fsi270308/-/README.md

### 高原气压模拟装置 ###
* __用于模拟高原大气压力，在模拟环境下测试产品的可靠性。__
---
> 电路原理
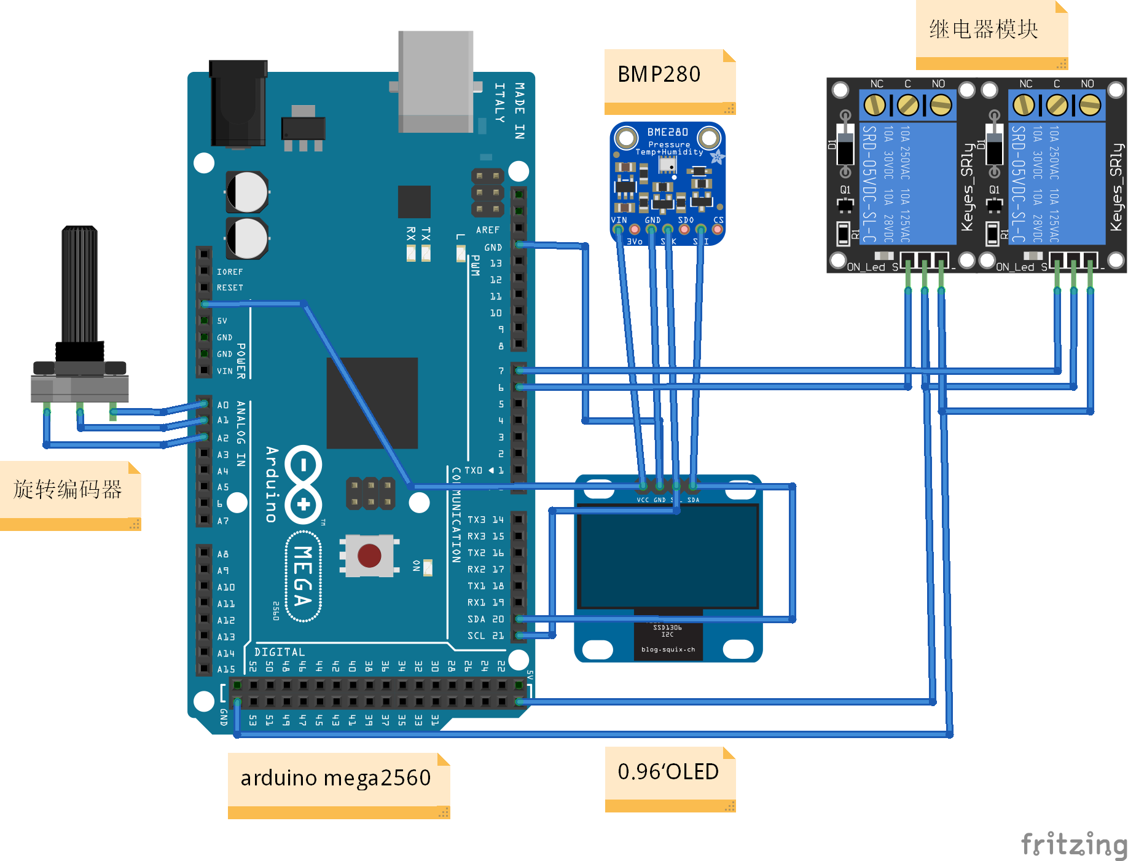
[picture p1: APSD_bb.png]
电路原理
> 
> 
> [详细内容见JZ-APSD.ino](/JZ-APSD.ino)
> 
> [操作说明](https://shimo.im/docs/Y8nY2oTyeAoOTrNK/)
