fsi270308/-/JZ-APSD.ino

/*
 * 2017/06/12  MaFeng
 * 大气压力模拟装置
 *    主控板：  Mega2560
 *    
 *    气压检测：BMP280模块
 *      接线方式：I2C  VCC->3.3V   GND->GND   SCL->SCL   SDA->SDA
 *      通信地址：0x76（在库Adafruit_BME280.h中修改）
 *      
 *    显示屏：12864 OLED模块0.96寸 （SSD1306_128X64）
 *      接线方式：I2C  VCC->3.3V   GND->GND   SCL->SCL   SDA->SDA
 *      通信地址：0x3C (Adafruit_SSD1306库，使用find_ad程序查找)
 *      
 *    操控按钮：旋转编码器模块 (RotaryEncoder)
 *      接线方式：CLK->A1  DT->A0  SW->A2  +->5V   GND->GND
 *      库：https://github.com/0xPIT/encoder/tree/arduino
 *      TimerOne库：https://github.com/PaulStoffregen/TimerOne
 *      旋转编码器原理：http://howtomechatronics.com/tutorials/arduino/rotary-encoder-works-use-arduino/
 *      参考：
 *      库：https://github.com/mathertel/RotaryEncoder     
 *      
 *    直流电机驱动： 继电器模块 光耦隔离低触发 12V
 *      接线方式：IN1->D6  IN2->D7
 *    
 *    当前大气压查询网址：中央气象台
 *    http://www.nmc.cn/publish/forecast/AJX/nanchang.html
 *    海平面气压的计算公式是：
 *        P0=Ps×10^[h/18400(1+Tm/273)]
 *    式中
 *        P0为海平面气压，单位hPa；
 *        Ps为本站气压，单位hPa；
 *        h为气压传感器拔海高度，单位为m；
 *        Tm为气柱平均温度，单位为℃，Tm=（t+t12)/2+h/400；
 *        t为干球温度，单位℃；
 *        t12为观测前12小时气温，单位℃。
 *        
 *    本地当天海平面气压查询网址：
 *    http://www.t7online.com//cgi-bin/regframe?3&PRG=detail&TIME=std&LANG=cn&WMO=58606&ART=luftdruck
 *    2017/6/13 14：00 南昌 海平面气压为：1007hpa  办公室海拔20m
 *    
 *    标准海平面气压为：1013.25hpa
 *    
 * 2017.6.18
 * 菜单程序测试成功
 * 2017.6.20
 * 增加继电器控制程序
 * 2017.6.23
 * 试验，泵启动到达设定值，补偿几次之后死机，泵工作不停。
 * 旋转编码器使用了中断，与I2C通讯冲突。
 * 2017.6.24
 * 死机原因参考1：http://www.dfrobot.com.cn/community/thread-12607-1-1.html
 * 死机原因参考2：http://www.wendangku.net/doc/8793f268561252d380eb6e79.html
 *    1.已在主循环中读取开关变量前关闭全局中断，完成后打开全局中断。
 *    2.减少函数调用层级，减少局部变量，测试30分钟，未死机。
 *    3.运行中气压传感器线接头接触不良也有可能导致死机。
 *    4.电源需接地，信号线加滤波器
 *    5.高速信号线I2C远离信号输入端
 * 2017.6.26
 * 程序优化，追加buff2，进一步减少局部变量。
 * 加看门狗Adafruit_SleepyDog.h，加断电保存，
 * EEPROM保存float型数据参考：http://www.arduino.cn/thread-2684-1-1.html
 * 2017.6.27
 * 原来是OLED连接线问题，排线时候使用了一根U槽传感器的四芯线，较细，而且有1米左右，线路绕在开关电源附近；
 * 更换了一根较粗的半米长四芯线，远离开关电源，问题解除，看门狗也不需要了。：P
 * 2017.6.29
 * 重做断电保存，更换库<EEPROM.h>为<EEPROMex.h>，更方便的存取各类数值。
*/

//----------------------加载库文件--------------------------------------------
#include <SPI.h>
#include <Wire.h>
#include <Adafruit_GFX.h>
#include <Adafruit_SSD1306.h>

#include <Adafruit_Sensor.h>  //气压传感器库
#include <Adafruit_BME280.h>  //气压传感器库

#include <ClickEncoder.h>
#include <TimerOne.h>

#include <EEPROMex.h>

#include <Adafruit_SleepyDog.h>

//----------------------大气压传感器本地海平面设置--------------------------------------
#define SEALEVELPRESSURE_HPA (seaLevelPressure)  //当地当天海平面大气压

//----------------------大气压传感器接线方式定义-------------------------------------------------
Adafruit_BME280 bme; // I2C

//----------------------OLED屏设置------------------------------------
#define OLED_RESET 4
Adafruit_SSD1306 display(OLED_RESET);

#define NUMFLAKES 10
#define XPOS 0
#define YPOS 1
#define DELTAY 2

#if (SSD1306_LCDHEIGHT != 64)
#error("Height incorrect, please fix Adafruit_SSD1306.h!");
#endif

//----------------------定义变量------------------------------------
int menuitem = 1;
int frame = 1;
int page = 2;
int lastMenuItem = 1;

String menuItem1 = "Home Screen";
String menuItem2 = "Sea Level Pressure";
String menuItem3 = "Simulation Altitude";
String menuItem4 = "Buff1";
String menuItem5 = "Buff2";
String menuItem6 = "Reset";

boolean vacuumPump = false;
int seaLevelPressure = 1013;
int siAltitude = 0;
float siAltitudeHm = 1.0; 
float buff1 = 20.0;  //默认大泵缓冲高度20m
float buff2 = 1.0;  //默认小泵滞后10m
int a1 = 0;
int a2 = 0;

int addr = 0;
float a3 = 0.0;
float a4 = 0.0;


boolean up = false;
boolean down = false;
boolean middle = false;

ClickEncoder *encoder;
int16_t last, value;

int pump1 = 6;    //泵1控制线D6
int pump2 = 7;    //泵2控制线D7
int i = 0;


void setup()   
{
  encoder = new ClickEncoder(A0, A1, A2);  //CLK -> A1; DT -> A0; SW -> A2
  encoder->setAccelerationEnabled(false);

  Wire.begin();  

  display.begin(SSD1306_SWITCHCAPVCC, 0x3C); 
  display.display();
  display.clearDisplay();

  Timer1.initialize(1000);
  Timer1.attachInterrupt(timerIsr); 
  
  last = encoder->getValue();

//-----------气压传感器启动----------------------------------
  bme.begin();
//------------真空泵初始化-----------------------------------
  pinMode(pump1, OUTPUT);
  pinMode(pump2, OUTPUT);
  digitalWrite(pump1, HIGH);
  digitalWrite(pump2, HIGH);
  
//------------EEPROM------------------------------------
        a1 = EEPROM.readInt(0);
        a2 = EEPROM.readInt(2);
        a3 = EEPROM.readFloat(4);
        a4 = EEPROM.readFloat(8);

  seaLevelPressure = a1;
  siAltitude = a2;
  buff2 = a3;
  buff1 = a4;
}



//-------------------↓↓↓Loop↓↓↓----------------------------------------------------
void loop() 
{  
    if(bme.readAltitude(SEALEVELPRESSURE_HPA) < siAltitudeHm)
    {
      if(bme.readAltitude(SEALEVELPRESSURE_HPA) < siAltitudeHm - buff1)
      {
        digitalWrite(pump1, LOW);   //pump1Start
        digitalWrite(pump2, LOW);   //pump2Start
        
      }
      else if(bme.readAltitude(SEALEVELPRESSURE_HPA) >= siAltitudeHm - buff1 && bme.readAltitude(SEALEVELPRESSURE_HPA) < siAltitudeHm - buff2)
      {
        digitalWrite(pump1, HIGH);   //pump1Stop
        digitalWrite(pump2, LOW);   //pump2Start
       vacuumPump = true;       
      }
    }
    else if(bme.readAltitude(SEALEVELPRESSURE_HPA) >= siAltitudeHm + buff2)
    {
      digitalWrite(pump1, HIGH);   //pump1Stop
      digitalWrite(pump2, HIGH);   //pump2Stop
      
    }

    if(vacuumPump)
    {
      vacuumPump = false;
      i ++;
      delay(200);
    }
    if(i >= 100)
    {
      i = 0;
      Watchdog.enable(50);   //补偿n次后看门狗启动。
      
    }
  
  siAltitudeHm = siAltitude * 100;   //显示为n百米
  
//----------------bme读取温湿度-----------------------------------------------------
  bme.readTemperature();   //必须读取这些值才能计算出准确的大气压
  bme.readHumidity();    //必须读取这些值才能计算出准确的大气压

//------------------显示菜单----------------------------------------------------
  drawMenu();
  
//------------------旋转编码器按钮状态读取-----------------------------
   noInterrupts();
   //readRotaryEncoder();
  value += encoder->getValue();  
  if (value/2 > last) 
  {
    last = value/2;
    down = true;
    delay(150);
  }
  else if (value/2 < last) 
  {
    last = value/2;
    up = true;
    delay(50);
  }
   ClickEncoder::Button b = encoder->getButton();   
   if (b != ClickEncoder::Open) 
   {
      switch (b) 
      {
      case ClickEncoder::Clicked:
        middle = true;
        break;
      }
    }    
  interrupts();
    
  //----------------------主菜单参数递减----------------------------------------
  if (up && page == 1 ) 
  {     
    up = false;
    if(menuitem == 2 && frame == 2)
    {
      frame--;
    }
    if(menuitem == 3 && frame == 3)
    {
      frame--;
    }
    if(menuitem == 4 && frame == 4)
    {
      frame--;
    }

    
    lastMenuItem = menuitem;
    menuitem--;
    
    if (menuitem==0)
    {
      menuitem=1;
    } 
  }
  
  //----------------------子菜单参数递减-----------------------------------------
  else if (up && page == 2 && menuitem == 2 ) 
  {
    up = false;
    seaLevelPressure--;
  }
  else if (up && page == 2 && menuitem == 3 ) 
  {
    up = false;
    siAltitude--;
    if(siAltitude == -2)
    {
      siAltitude = 40;
    }
  }
  else if (up && page == 2 && menuitem == 4 ) 
  {
    up = false;
    buff1--;
    if(buff1 == -1.00)
    {
      buff1 = 100;
    }
  }
  else if (up && page == 2 && menuitem == 5 ) 
  {
    up = false;
    buff2--;
    if(buff2 == -1.00)
    {
      buff2 = 10;
    }
  }
  
//---------------------------主菜单参数递增---------------------------------------------------
  if (down && page == 1)              //We have turned the Rotary Encoder Clockwise
  {
    down = false;
    if(menuitem == 3 && lastMenuItem == 2)
    {
      frame ++;
    }
    else if(menuitem == 4 && lastMenuItem == 3)
    {
      frame ++;
    }
    else if(menuitem == 5 && lastMenuItem == 4 && frame!=4)
    {
      frame ++;
    }
    
    lastMenuItem = menuitem;
    menuitem++;  
    
    if (menuitem==7) 
    {
      menuitem--;
    }  
  }
  
  //---------------------子菜单参数递增----------------------------------------
  else if (down && page == 2 && menuitem == 2) 
  {
    down = false;
    seaLevelPressure++;
  }
  else if (down && page == 2 && menuitem == 3) 
  {
    down = false;
    siAltitude++;
    if(siAltitude == 41)
    {
      siAltitude = -1;
    }
  }
  else if (down && page == 2 && menuitem == 4) 
  {
    down = false;
    buff1++;
    if(buff1 == 101.00)
    {
      buff1 = 0;
    }
   }
  else if (down && page == 2 && menuitem == 5) 
  {
    down = false;
    buff2++;
    if(buff2 == 11.00)
    {
      buff2 = 0;
    }
   }
  
  //-------------------中间按钮按下---------------------------------------
  if (middle) //Middle Button is Pressed
  {
    middle = false;
    if(page == 1 && menuitem == 6)      // Reset
    {
      resetDefaults();
    }
    else if (page == 1 && menuitem <= 5) 
    {
      page=2;
     }
    else if (page == 2) 
     {
      page=1; 
      
      a1 = seaLevelPressure;
      a2 = siAltitude;
      a3 = buff2;
      a4 = buff1;
 
      EEPROM.updateInt(0, a1);
      EEPROM.updateInt(2, a2);
      EEPROM.updateFloat(4, a3);
      EEPROM.updateFloat(8, a4);
     }
   }   
  }
//--------------------------↑↑↑Loop↑↑↑------------------------------------------
  
  void drawMenu()
{    
  if (page == 1) 
  {    
    display.setTextSize(1);
    display.clearDisplay();
    display.setTextColor(WHITE);
    display.setCursor(37, 0);
    display.print("MAIN MENU");
    display.drawFastHLine(0,10,128,WHITE);

    if(menuitem == 1 && frame == 1)
    {   
      displayMenuItem(menuItem1, 15,false);
      displayMenuItem(menuItem2, 25,true);
      displayMenuItem(menuItem3, 35,true);
    }
    else if(menuitem == 2 && frame == 1)
    {
      displayMenuItem(menuItem1, 15,true);
      displayMenuItem(menuItem2, 25,false);
      displayMenuItem(menuItem3, 35,true);
    }
    else if(menuitem == 3 && frame == 1)
    {
      displayMenuItem(menuItem1, 15,true);
      displayMenuItem(menuItem2, 25,true);
      displayMenuItem(menuItem3, 35,false);
    }
     else if(menuitem == 4 && frame == 2)
    {
      displayMenuItem(menuItem2, 15,true);
      displayMenuItem(menuItem3, 25,true);
      displayMenuItem(menuItem4, 35,false);
    }

      else if(menuitem == 3 && frame == 2)
    {
      displayMenuItem(menuItem2, 15,true);
      displayMenuItem(menuItem3, 25,false);
      displayMenuItem(menuItem4, 35,true);
    }
    else if(menuitem == 2 && frame == 2)
    {
      displayMenuItem(menuItem2, 15,false);
      displayMenuItem(menuItem3, 25,true);
      displayMenuItem(menuItem4, 35,true);
    }
    
    else if(menuitem == 5 && frame == 3)
    {
      displayMenuItem(menuItem3, 15,true);
      displayMenuItem(menuItem4, 25,true);
      displayMenuItem(menuItem5, 35,false);
    }

    else if(menuitem == 6 && frame == 4)
    {
      displayMenuItem(menuItem4, 15,true);
      displayMenuItem(menuItem5, 25,true);
      displayMenuItem(menuItem6, 35,false);
    }
    
      else if(menuitem == 5 && frame == 4)
    {
      displayMenuItem(menuItem4, 15,true);
      displayMenuItem(menuItem5, 25,false);
      displayMenuItem(menuItem6, 35,true);
    }
      else if(menuitem == 4 && frame == 4)
    {
      displayMenuItem(menuItem4, 15,false);
      displayMenuItem(menuItem5, 25,true);
      displayMenuItem(menuItem6, 35,true);
    }
    else if(menuitem == 3 && frame == 3)
    {
      displayMenuItem(menuItem3, 15,false);
      displayMenuItem(menuItem4, 25,true);
      displayMenuItem(menuItem5, 35,true);
    }
        else if(menuitem == 2 && frame == 2)
    {
      displayMenuItem(menuItem2, 15,false);
      displayMenuItem(menuItem3, 25,true);
      displayMenuItem(menuItem4, 35,true);
    }
    else if(menuitem == 4 && frame == 3)
    {
      displayMenuItem(menuItem3, 15,true);
      displayMenuItem(menuItem4, 25,false);
      displayMenuItem(menuItem5, 35,true);
    }   
    display.display();
  }
  else if (page==2 && menuitem == 1) 
  {    
   displayHomeScreen();
  }
  else if (page==2 && menuitem == 2) 
  {
   displayIntMenuPage(menuItem2, seaLevelPressure);
  }
   else if (page==2 && menuitem == 3) 
  {
   displayFloatMenuPage(menuItem3, siAltitudeHm);
  }
  else if (page==2 && menuitem == 4) 
  {
   displayFloatMenuPage(menuItem4, buff1);
  }
  else if (page==2 && menuitem == 5) 
  {
   displayFloatMenuPage(menuItem5, buff2);
  }
 }

//----------------恢复默认值-------------------------------------------------
  void resetDefaults()
  {
    seaLevelPressure = 1013;
    siAltitude = 0;
    buff1 = 20.0;
    buff2 = 1.0;

   /* for (int x = 0; x < EEPROM.length(); x = x + 1)   //Loop end of EEPROM address
    {    
        if (EEPROM.read(x) == 0)   //If EEPROM address 0
        {              
          // do nothing, already clear, go to the next address in order to save time and reduce writes to EEPROM
        }
        else {
          EEPROM.write(x, 0);       // if not write 0 to clear, it takes 3.3mS
        }
      }  */ 
  }

//-----------------旋转编码器中断---------------------------------------------------------
  void timerIsr() 
  {
  encoder->service();
  }

//---------------------主界面-------------------------------------------
void displayHomeScreen()
{
    display.setTextSize(1);
    display.clearDisplay();
    display.setTextColor(WHITE);
    display.setCursor(0, 0);
    display.print("JZ-APSD");
    display.setCursor(65, 0);
    display.print(i);
    display.drawFastHLine(0,10,128,WHITE);
    display.setCursor(5, 15);
    display.print("Altitude");
    display.setCursor(5+12, 25);
    display.print("(m)");
    display.setTextSize(2);
    display.setCursor(5, 35);
    display.print(bme.readAltitude(SEALEVELPRESSURE_HPA), 0);
    
    display.setTextSize(1);
    display.setCursor(65, 15);
    display.print("Pressure");
    display.setCursor(65+12, 25);
    display.print("(hpa)");
    display.setTextSize(2);
    display.setCursor(65, 35);
    display.print(bme.readPressure() / 100.0F, 0);

    display.display();
}

//---------------------子菜单显示程序（int型）-------------------------------------------
void displayIntMenuPage(String menuItem, int value)
{
    display.setTextSize(1);
    display.clearDisplay();
    display.setTextColor(WHITE);
    display.setCursor(5, 0);
    display.print(menuItem);
    display.drawFastHLine(0,10,128,WHITE);
    display.setCursor(5, 15);
    display.print("Value");
    display.setTextSize(2);
    display.setCursor(5, 25);
    display.print(value);
    display.setTextSize(2);
    display.display();
}

//---------------------子菜单显示程序（float型）-------------------------------------------
void displayFloatMenuPage(String menuItem, float value)
{
    display.setTextSize(1);
    display.clearDisplay();
    display.setTextColor(WHITE);
    display.setCursor(5, 0);
    display.print(menuItem);
    display.drawFastHLine(0,10,128,WHITE);
    display.setCursor(5, 15);
    display.print("Value");
    display.setTextSize(2);
    display.setCursor(5, 25);
    display.print(value);
    display.setTextSize(2);
    display.display();
}

//---------------------子菜单显示程序（string型）-------------------------------------------
void displayStringMenuPage(String menuItem, String value)
{
    display.setTextSize(1);
    display.clearDisplay();
    display.setTextColor(WHITE);
    display.setCursor(15, 0);
    display.print(menuItem);
    display.drawFastHLine(0,10,128,WHITE);
    display.setCursor(5, 15);
    display.print("Value");
    display.setTextSize(2);
    display.setCursor(5, 25);
    display.print(value);
    display.setTextSize(2);
    display.display();
}

//----------------------------主菜单显示程序--------------------------------------------
void displayMenuItem(String item, int position, boolean selected)
{
    if(selected)
    {
      display.setTextColor(WHITE, BLACK);    //字体、填充颜色
    }
    else
    {
      display.setTextColor(BLACK, WHITE);
    }
    display.setCursor(0, position);
    display.print(">"+item);
}
