fsi270308/-/(commit log)

2017-06-13 Create Encoder 360
    encoder360测试。
2017-06-18 程序优化
2017-06-18 find_ad
    查找OLED屏通信地址
2017-06-23 Update JZ-APSD.ino
    最终程序
2017-06-27 所需库（arduino版本1.6.7）
